Champers5000/FauxLightWindow/README.md

# FauxLightWindow
Designed to emulate the sun in a windowless space. 
* Uses GPS to determine your location and time in order to calculate luminosity at that location. 
* Electronics implement flickerless dimming of LEDs through a controllable constant current buck converter
