Champers5000/FauxLightWindow/LightingBoard/LightingBoard.kicad_pcb

## KiCad design LightingBoard/LightingBoard.kicad_pcb (2024-03-30)

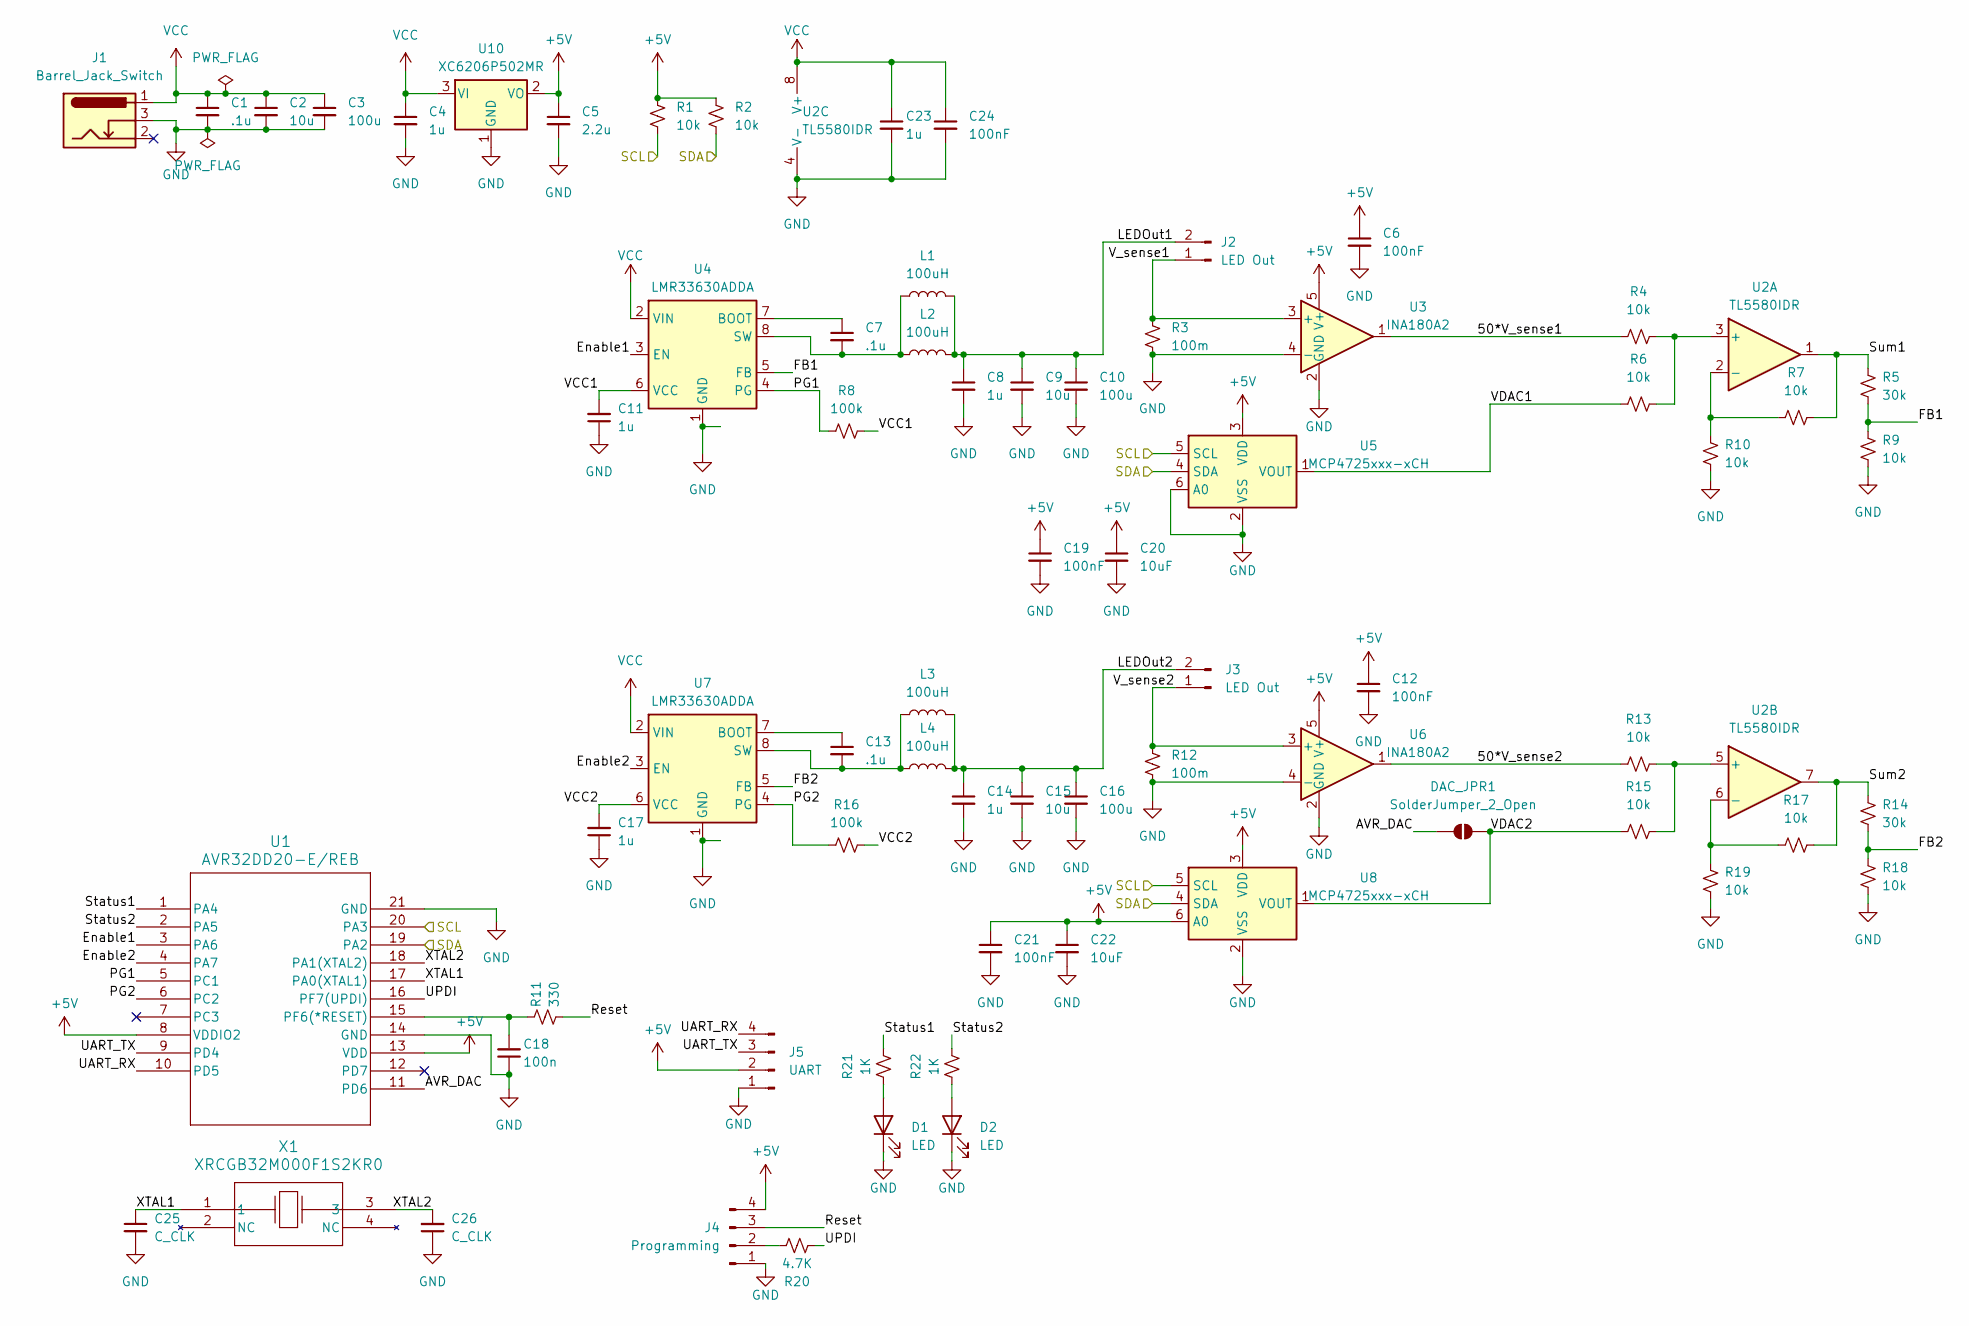
[picture p1: schematic LightingBoard.kicad_sch]

Parts:
C1: .1u; C_0805_2012Metric
C2, C9, C15: 10u; C_0805_2012Metric
C3, C10, C16: 100u; CP_Elec_6.3x7.7
C4, C11, C17, C23: 1u; C_0603_1608Metric
C5: 2.2u; C_0603_1608Metric
C6, C12, C19, C21, C24: 100nF; C_0603_1608Metric
C7, C13: .1u; C_0603_1608Metric
C8, C14: 1u; C_0805_2012Metric
C18: 100n; C_0603_1608Metric
C20, C22: 10uF; C_0603_1608Metric
C25, C26: C_CLK; C_0603_1608Metric
D1, D2: LED; LED_0805_2012Metric
DAC_JPR1: SolderJumper_2_Open; SolderJumper-2_P1.3mm_Open_RoundedPad1.0x1.5mm
J1: Barrel_Jack_Switch; BarrelJack_Horizontal
J2, J3: LED Out; PinSocket_1x02_P2.54mm_Vertical
J4: Programming; PinSocket_1x04_P2.54mm_Vertical
J5: UART; JST_SH_BM04B-SRSS-TB_1x04-1MP_P1.00mm_Vertical
L1, L3: 100uH; 7447231101
L2, L4: 100uH; IND_BOURNS_SDR1307
R1, R2, R4, R6, R7, R9, R10, R13, R15, R17, R18, R19: 10k; R_0603_1608Metric
R3, R12: 100m; R_1206_3216Metric
R5, R14: 30k; R_0603_1608Metric
R8, R16: 100k; R_0603_1608Metric
R11: 330; R_0603_1608Metric
R20: 4.7K; R_0603_1608Metric
R21, R22: 1K; R_0603_1608Metric
U1: AVR32DD20-E/REB; VQFN-20-1EP_3x3mm_P0.4mm_EP1.7x1.7mm
U2: TL5580IDR; SOIC-8_3.9x4.9mm_P1.27mm
U3, U6: INA180A2; SOT-23-5
U4, U7: LMR33630ADDA; Texas_HSOP-8-1EP_3.9x4.9mm_P1.27mm_ThermalVias
U5, U8: MCP4725xxx-xCH; SOT-23-6
U10: XC6206P502MR; SOT-23
X1: XRCGB32M000F1S2KR0; Crystal_SMD_2016-4Pin_2.0x1.6mm

Connections:
+5V: C5.1, C6.1, C12.1, C19.1, C20.1, C21.1, C22.1, J4.4, J5.2, R1.1, R2.1, U1.8 (VDDIO2), U1.13 (VDD), U3.5 (V+), U5.3 (VDD), U6.5 (V+), U8.3 (VDD), U8.6 (A0), U10.2 (VO)
/50*V_sense1: R4.2, U3.1
/50*V_sense2: R13.2, U6.1
/AVR_DAC: DAC_JPR1.1 (A), U1.11 (PD6)
/Enable1: U1.3 (PA6), U4.3 (EN)
/Enable2: U1.4 (PA7), U7.3 (EN)
/FB1: R5.1, R9.2, U4.5 (FB)
/FB2: R14.1, R18.2, U7.5 (FB)
/LEDOut1: C8.1, C9.1, C10.1, J2.2, L1.2, L2.2
/LEDOut2: C14.1, C15.1, C16.1, J3.2, L3.2, L4.2
/PG1: R8.1, U1.5 (PC1), U4.4 (PG)
/PG2: R16.1, U1.6 (PC2), U7.4 (PG)
/Reset: J4.3, R11.1
/SCL: R1.2, U1.20 (PA3), U5.5 (SCL), U8.5 (SCL)
/SDA: R2.2, U1.19 (PA2), U5.4 (SDA), U8.4 (SDA)
/Status1: R21.2, U1.1 (PA4)
/Status2: R22.2, U1.2 (PA5)
/Sum1: R5.2, R7.1, U2.1
/Sum2: R14.2, R17.1, U2.7
/UART_RX: J5.4, U1.10 (PD5)
/UART_TX: J5.3, U1.9 (PD4)
/UPDI: R20.1, U1.16 (PF7(UPDI))
/VCC1: C11.2, R8.2, U4.6 (VCC)
/VCC2: C17.2, R16.2, U7.6 (VCC)
/VDAC1: R6.2, U5.1 (VOUT)
/VDAC2: DAC_JPR1.2 (B), R15.2, U8.1 (VOUT)
/V_sense1: J2.1, R3.1, U3.3 (+)
/V_sense2: J3.1, R12.1, U6.3 (+)
/XTAL1: C25.1, U1.17 (PA0(XTAL1)), X1.1
/XTAL2: C26.2, U1.18 (PA1(XTAL2)), X1.3
GND: C1.2, C2.2, C3.2, C4.2, C5.2, C6.2, C8.2, C9.2, C10.2, C11.1, C12.2, C14.2, C15.2, C16.2, C17.1, C18.1, C19.2, C20.2, C21.2, C22.2, C23.2, C24.2, C25.2, C26.1, D1.1 (K), D2.1 (K), J1.3, J4.1, J5.1, R3.2, R9.1, R10.1, R12.2, R18.1, R19.1, U1.14 (GND), U1.21 (GND), U2.4 (V-), U3.2 (GND), U3.4 (-), U4.1 (PGND), U4.9 (AGND), U5.2 (VSS), U5.6 (A0), U6.2 (GND), U6.4 (-), U7.1 (PGND), U7.9 (AGND), U8.2 (VSS), U10.1 (GND)
unnamed: D1.2 (A), R21.1
unnamed: D2.2 (A), R22.1
unnamed: J4.2, R20.2
unnamed: C18.2, R11.2, U1.15 (PF6(*RESET))
unnamed: R4.1, R6.1, U2.3 (+)
unnamed: R7.2, R10.2, U2.2 (-)
unnamed: R13.1, R15.1, U2.5 (+)
unnamed: R17.2, R19.2, U2.6 (-)
unnamed: C7.1, U4.7 (BOOT)
unnamed: C7.2, L1.1, L2.1, U4.8 (SW)
unnamed: C13.1, U7.7 (BOOT)
unnamed: C13.2, L3.1, L4.1, U7.8 (SW)
VCC: C1.1, C2.1, C3.1, C4.1, C23.1, C24.1, J1.1, U2.8 (V+), U4.2 (VIN), U7.2 (VIN), U10.3 (VI)

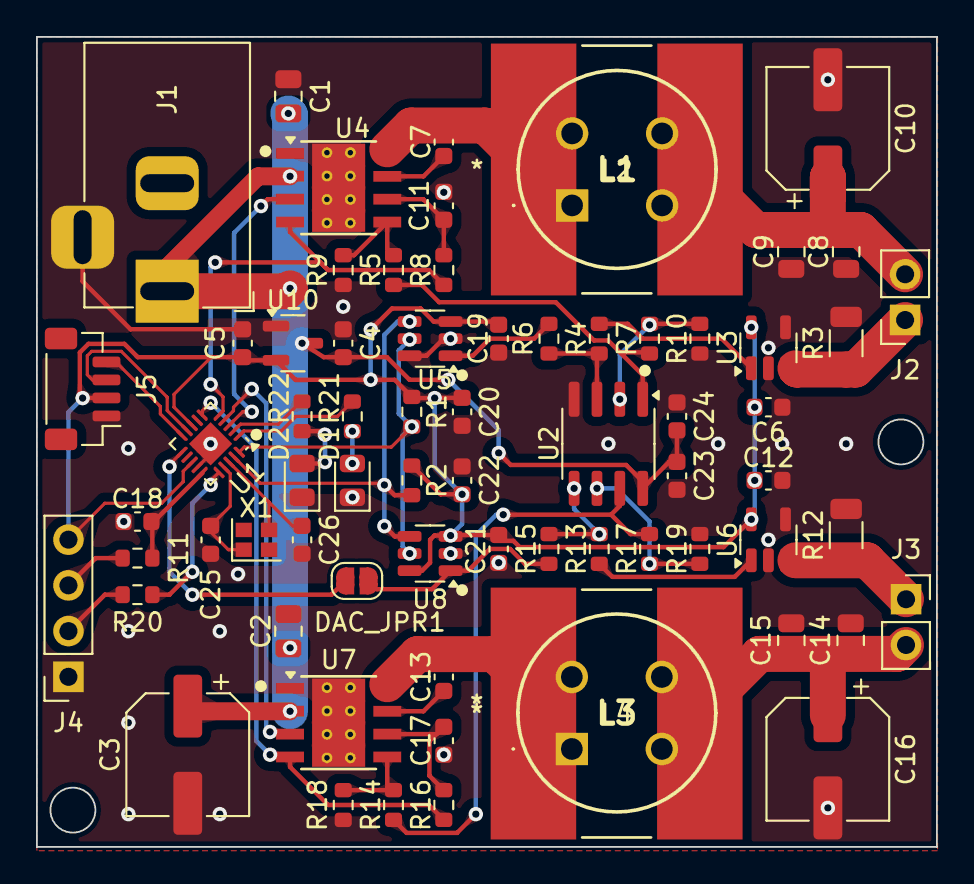
[picture p2: board LightingBoard.kicad_pcb from above]

Board: 2 copper layers, 50.0 x 45.0 mm, 70 parts (0 on the bottom side), 44 nets.
