Champers5000/FauxLightWindow/(threads)

Thread 3 (2024-01-05):

Voltage divider of 40k/10k too close to 1V limit

Champers5000, 2024-01-05:
Ya CS amplifier can't produce a full 5v and the output never goes to 1V
