Champers5000/FauxLightWindow/(commit log)

2023-11-14 Circuit and PCB
    [CurrentControl.kicad_sch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]
2024-01-04 add cost estimates
    [LightingBoard.kicad_sch]
2024-01-04 NO MORR DINOSAURR
    [LightingBoard.kicad_pcb, LightingBoard.kicad_sch]
2024-01-07 fix some issues
    [LightingBoard.kicad_sch]
2024-02-06 ignore gerber
2024-02-06 working intensity code
    [LightingBoard-B_Cu.gbr, LightingBoard-B_Mask.gbr, LightingBoard-B_Paste.gbr, LightingBoard-B_Silkscreen.gbr, LightingBoard-Edge_Cuts.gbr, LightingBoard-F_Cu.gbr, LightingBoard-F_Mask.gbr, LightingBoard-F_Paste.gbr]
2024-02-18 new design based on AVR32DD20
    [LightingBoard.kicad_pcb, LightingBoard.kicad_sch]
2024-03-30 update to kicad 8
    [LightingBoard.kicad_pcb, LightingBoard.kicad_sch]
2024-03-30 center a via
    [LightingBoard.kicad_pcb]
